gusghrlrl101/Diving-Computer/공용 문서.docx

- [2019.05.10]
  - 현호

ㅎㅇ

  - 형인

05.14 : 질문 리스트 및 To do List

  - MSP430 런치패드 및 J-TAG 대여가능 여부 (학과 사무실 문의결과 없었음)
  - 새로 조사한 센서 검사(압력 센서, ntc thermistor)
    - 온도센서 : http://www.devicemart.co.kr/goods/view?no=1247062
    - 압력센서 : https://cn-htdz.en.alibaba.com/product/62055535367-220322420/2019_hot_sale_China_19mm_dimension_Titanium_Hastelloy_Diaphragm_Piezoresistive_Silicon_1_5mA_Pressure_Se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
  - 회로도 작성 중 생기는 issue 정리
  - UI/UX 문서화
  - 센서 해외배송으로 스케쥴 조정 필요(센서 파트를 뒤로, 메모리, LCD화면 출력 test 먼저)
