gusghrlrl101/Diving-Computer/Datasheet/만능기판.PNG

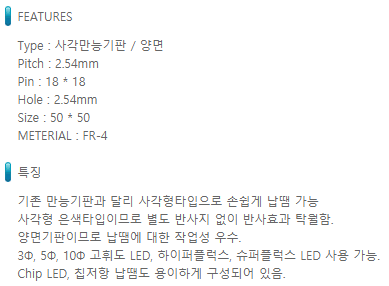
Datasheet/만능기판.PNG
