gusghrlrl101/Diving-Computer/Datasheet/배터리.PNG

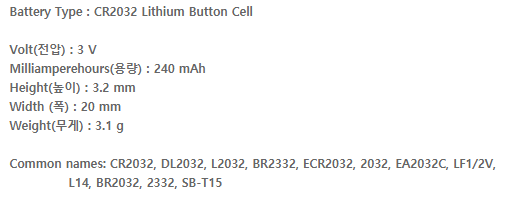
Datasheet/배터리.PNG
