gusghrlrl101/Diving-Computer/Datasheet/배터리홀더.PNG

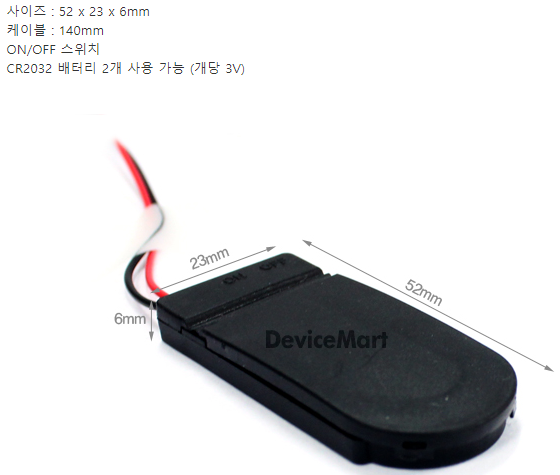
Datasheet/배터리홀더.PNG
