gusghrlrl101/Diving-Computer/Datasheet/변환기판.PNG

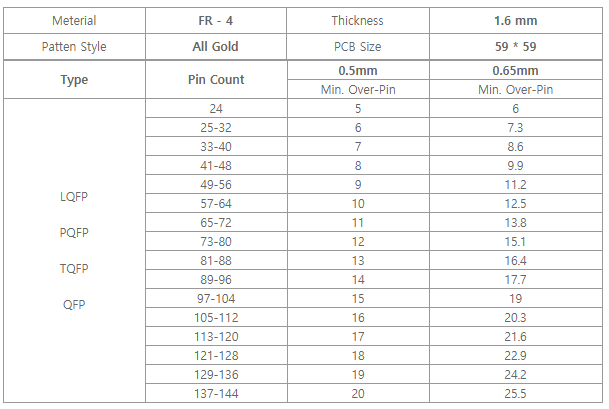
Datasheet/변환기판.PNG
