gusghrlrl101/Diving-Computer/Datasheet/부저.PNG

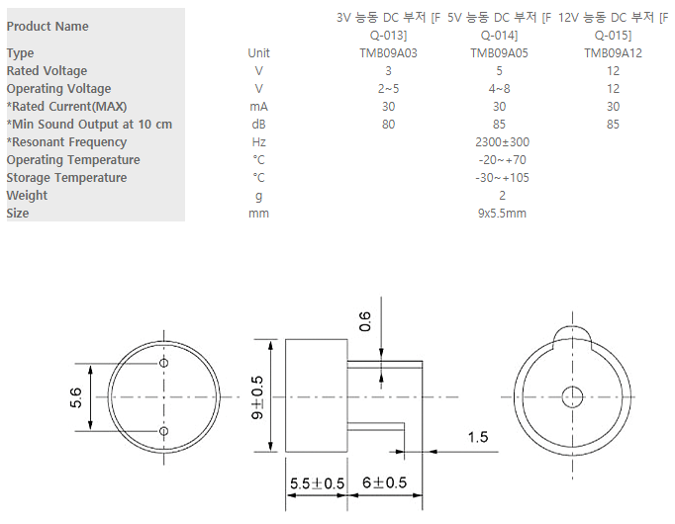
Datasheet/부저.PNG
