gusghrlrl101/Diving-Computer/Datasheet/스위치.PNG

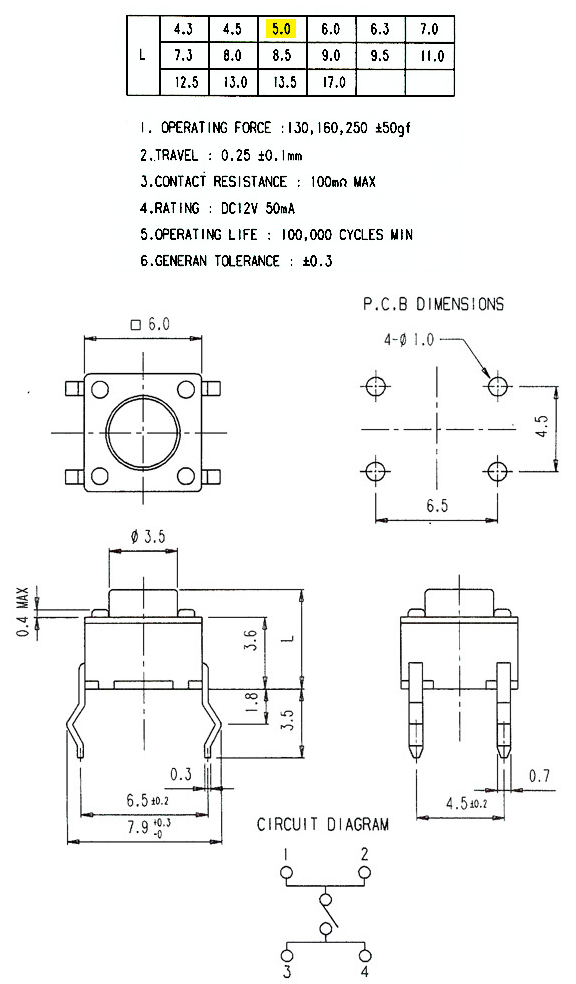
Datasheet/스위치.PNG
