gusghrlrl101/Diving-Computer/예산안.xlsx

<임베디드시스템설계 예산안> 12141755 임현호, 12141777 최형인
NO. | 구분 | 세부사항 / 상품명 | 구매 개수 | 단가 | 가격(원) | 물품 구입 URL 혹은 구입처 명시
1 | MCU | MSP430FR5972IPMR | 2 | 6116 | 12232 | https://www.digikey.kr/product-detail/ko/texas-instruments/MSP430FR5972IPMR/296-50528-1-ND/9685667
2 | MCU lanchpad | MSP-EXP430FR5994 | 1 | 21975 | 21975 | https://www.digikey.kr/products/ko/development-boards-kits-programmers/evaluation-boards-embedded-mcu-dsp/786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
4 | PCB board | 50 x 50 사각 만능 기판 - 양면 | 4 | 1100 | 4400 | http://www.devicemart.co.kr/goods/view?no=24845
5 | PCB board | G308 변환 기판 | 2 | 7000 | 14000 | http://www.devicemart.co.kr/goods/view?no=23393
7 | Pressure Sensor | MS5803-14BA | 2 | 17075 | 34150 | https://www.digikey.kr/product-detail/ko/MS580314BA01-00/223-1626-5-ND/5277631
9 | LCD | NHD-C0216CIZ-FSW-FBW-3V3 | 2 | 12664 | 25318 | https://www.digikey.kr/product-detail/ko/NHD-C0216CIZ-FSW-FBW-3V3/NHD-C0216CIZ-FSW-FBW-3V3-ND/2165872/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
11 | Buzzer | SM-1205C | 2 | 500 | 1000 | http://www.devicemart.co.kr/goods/view?no=2736
12 | Buzzer | FQ-013 | 2 | 500 | 1000 | http://www.devicemart.co.kr/goods/view?no=1361183
13 | Switch | ITS-1105-5mm | 10 | 40 | 400 | http://www.devicemart.co.kr/goods/view?no=34555
14 | Switch | ITS-1105-7mm | 10 | 40 | 400 | http://www.devicemart.co.kr/goods/view?no=34557
15 | Switch | ITS-1105-9mm | 10 | 50 | 500 | http://www.devicemart.co.kr/goods/view?no=34560
16 | Battery | CR2032-BP(3V)Pa | 6 | 500 | 3000 | http://www.devicemart.co.kr/goods/view?no=2931
17 | BatteryHolder | SZH-BH001 | 2 | 1000 | 2000 | http://www.devicemart.co.kr/goods/view?no=1278961
19 | Regulator | LM7805ACT | 2 | 900 | 1800 | http://www.devicemart.co.kr/goods/view?no=1322882
20 | Header | 2*10 pin header | 2 | 150 | 300 | http://www.devicemart.co.kr/goods/view?no=251
21 | Line | USB2.0 케이블 [AM-BM] | 1 | 600 | 600 | http://www.devicemart.co.kr/goods/view?no=1112200
22
23
총 금액 : |  |  |  | 123075
2019. . . 작성자: (인) (인) 지도교수: (인)
