gusghrlrl101/Diving-Computer/dive_com_circuit.pdf

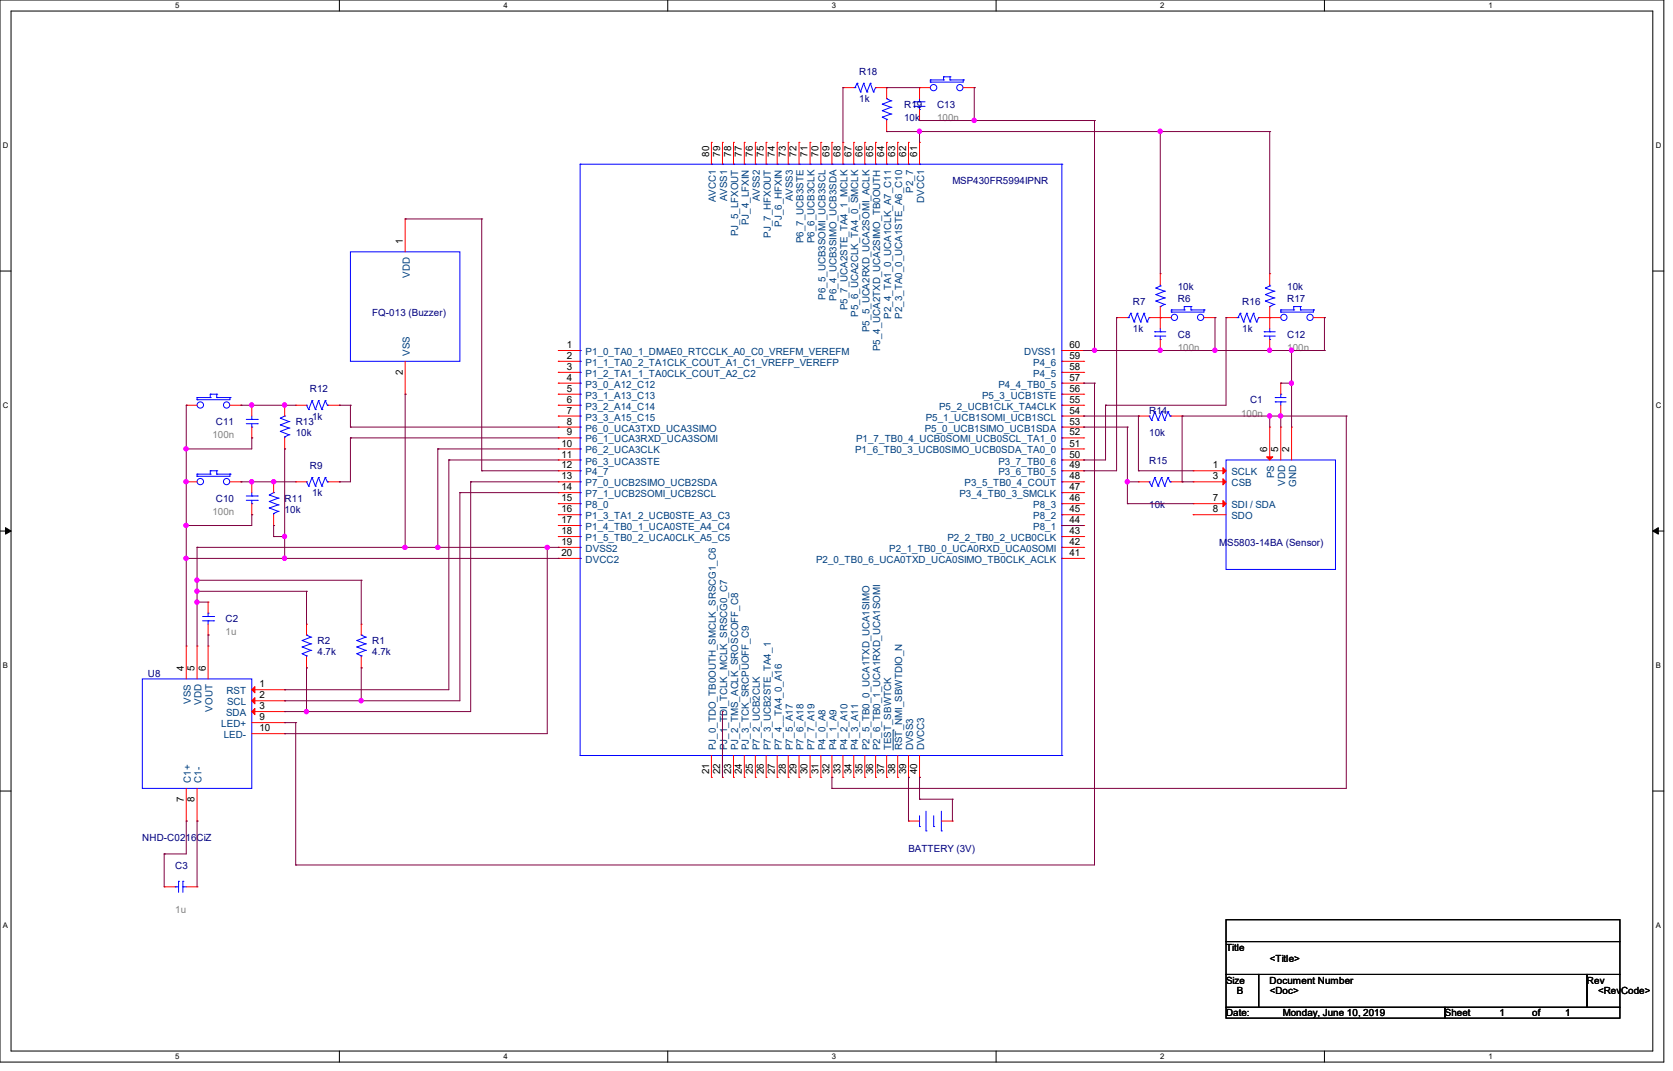
[picture p23: page 1]
