gusghrlrl101/Diving-Computer/(list of files, drawings)

Other design files:
OrCAD/DIVING_COMPUTER.DSN
OrCAD/Diving_Computer.opj
OrCAD/LIBRARY1.OLB
OrCAD/library1.opj
OrCAD/MSP430FR5972IPMR.OLB
OrCAD/MSP430FR5994IPNR.OLB
