gusghrlrl101/Diving-Computer/CCS/new 1.c

Skip to content
 
Search or jump to…

Pull requests
Issues
Marketplace
Explore
 
@3larvas 
49
5 5 sparkfun/SparkFun_MS5803-14BA_Breakout_Arduino_Library
 Code  Issues 0  Pull requests 0  Projects 0  Wiki  Security  Insights
SparkFun_MS5803-14BA_Breakout_Arduino_Library/examples/SparkFun_MS5803_Demo/SparkFun_MS5803_Demo.ino
@bboyho bboyho Fix issue with initializing I2C Bus on SAMD21, ESP8266
fb6d08d 25 days ago
132 lines (94 sloc)  3.95 KB
    

/******************************************************************************
  SparkFun_MS5803_Demo.ino
  Demo Program for MS5803 pressure sensors.
  Casey Kuhns @ SparkFun Electronics
  7/20/2014
  https://github.com/sparkfun/MS5803-14BA_Breakout/
  The MS58XX MS57XX and MS56XX by Measurement Specialties is a low cost I2C pressure
  sensor.  This sensor can be used in weather stations and for altitude
  estimations. It can also be used underwater for water depth measurements.
  Resources:
  This library uses the Arduino Wire.h to complete I2C transactions.
  Development environment specifics:
	IDE: Arduino 1.0.5
	Hardware Platform: Arduino Pro 3.3V/8MHz
	T5403 Breakout Version: 1.0
**Updated for Arduino 1.8.8 5/2019**
  This code is beerware. If you see me (or any other SparkFun employee) at the
  local pub, and you've found our code helpful, please buy us a round!
  Distributed as-is; no warranty is given.
******************************************************************************/

#include <Wire.h>
#include <SparkFun_MS5803_I2C.h> // Click here to get the library: http://librarymanager/All#SparkFun_MS5803-14BA

// Begin class with selected address
// available addresses (selected by jumper on board)
// default is ADDRESS_HIGH

//  ADDRESS_HIGH = 0x76
//  ADDRESS_LOW  = 0x77

MS5803 sensor(ADDRESS_HIGH);

//Create variables to store results
float temperature_c, temperature_f;
double pressure_abs, pressure_relative, altitude_delta, pressure_baseline;

// Create Variable to store altitude in (m) for calculations;
double base_altitude = 1655.0; // Altitude of SparkFun's HQ in Boulder, CO. in (m)

void setup() {
  // Start your preferred I2C object
  Wire.begin();
  //Initialize Serial Monitor
  Serial.begin(9600);
  //Retrieve calibration constants for conversion math.
  sensor.reset();
  sensor.begin();

  pressure_baseline = sensor.getPressure(ADC_4096);

}

void loop() {

  // To measure to higher degrees of precision use the following sensor settings:
  // ADC_256
  // ADC_512
  // ADC_1024
  // ADC_2048
  // ADC_4096

  // Read temperature from the sensor in deg C. This operation takes about
  temperature_c = sensor.getTemperature(CELSIUS, ADC_512);

  // Read temperature from the sensor in deg F. Converting
  // to Fahrenheit is not internal to the sensor.
  // Additional math is done to convert a Celsius reading.
  temperature_f = sensor.getTemperature(FAHRENHEIT, ADC_512);

  // Read pressure from the sensor in mbar.
  pressure_abs = sensor.getPressure(ADC_4096);

  // Let's do something interesting with our data.

  // Convert abs pressure with the help of altitude into relative pressure
  // This is used in Weather stations.
  pressure_relative = sealevel(pressure_abs, base_altitude);

  // Taking our baseline pressure at the beginning we can find an approximate
  // change in altitude based on the differences in pressure.
  altitude_delta = altitude(pressure_abs , pressure_baseline);

  // Report values via UART
  Serial.print("Temperature C = ");
  Serial.println(temperature_c);

  Serial.print("Temperature F = ");
  Serial.println(temperature_f);

  Serial.print("Pressure abs (mbar)= ");
  Serial.println(pressure_abs);

  Serial.print("Pressure relative (mbar)= ");
  Serial.println(pressure_relative);

  Serial.print("Altitude change (m) = ");
  Serial.println(altitude_delta);

  Serial.println(" ");//padding between outputs

  delay(1000);

}


// Thanks to Mike Grusin for letting me borrow the functions below from
// the BMP180 example code.

double sealevel(double P, double A)
// Given a pressure P (mbar) taken at a specific altitude (meters),
// return the equivalent pressure (mbar) at sea level.
// This produces pressure readings that can be used for weather measurements.
{
  return (P / pow(1 - (A / 44330.0), 5.255));
}


double altitude(double P, double P0)
// Given a pressure measurement P (mbar) and the pressure at a baseline P0 (mbar),
// return altitude (meters) above baseline.
{
  return (44330.0 * (1 - pow(P / P0, 1 / 5.255)));
}
© 2019 GitHub, Inc.
Terms
Privacy
Security
Status
Help
Contact GitHub
Pricing
API
Training
Blog
About
