gusghrlrl101/Diving-Computer/(commit log)

2019-05-18 add datasheet
    [예산안.xlsx]
2019-05-18 edit ORCAD
    ORCAD 회로도 작성 (Jtag 제외)
    MSP430 User Guide 파일 추가
    [DIVING_COMPUTER.DSN, Diving_Computer.opj, LIBRARY1.OLB, 예산안.xlsx]
2019-05-19 make jtag to ORCAD
    [DIVING_COMPUTER.DSN, Diving_Computer.opj, LIBRARY1.OLB]
2019-05-19 add module's name
    [DIVING_COMPUTER.DSN, Diving_Computer.opj]
2019-05-19 add circuit
2019-05-23 add msp430fr5994 datasheet
    [Diving_Computer.opj]
2019-05-28 modify circuit
    [DIVING_COMPUTER.DSN, Diving_Computer.opj]
2019-05-28 edit circuit
    [DIVING_COMPUTER.DSN, Diving_Computer.opj, MSP430FR5994IPNR.OLB]
2019-06-04 up, down switch implement
    [Diving_Computer.opj, library1.opj]
2019-06-05 non perfect timer
2019-06-05 Update switch.h
    모드 변경 시 인터럽트 해제
    WATER모드에서는 1분 인터럽트 쓰는데, 다른데 갈때 이걸 해제하고, 다시 WATER모드 될때 이걸 적용
2019-06-06 edit power button & backlight mode
2019-06-06 low power complete
2019-06-06 몇개 수정
2019-06-06 sensor ongoing..
2019-06-08 sensor completed
2019-06-09 auto measure mode & buzzer alarm & buzzer info
    [lcd.h, main.c, mem.h, sensor.h, switch.h, timer.h]
2019-06-09 final commit
    [DIVING_COMPUTER.DSN, Diving_Computer.opj, LIBRARY1.OLB]
